akita11/PT2/FW/LED_definition.md

# LEDの挙動

LEDの挙動は以下の通りとします。

## 起動時

50msごとにで全LEDを順に1個ずつのみ点灯（他は消灯）、ランダムな色で点灯させ、最後に全消灯。

## プログラム実行中

- 実行中のブロックを赤で点滅。
- loopブロックのLEDは、loopを実行中は緑色で点灯。loop実行が終わったら、そのブロックは消灯。

## プログラム終了後

200ms周期で3回、全LEDを青点滅
