akita11/PT2/PCB/PT2one.kicad_pcb

## KiCad design PCB/PT2one.kicad_pcb (2026-10-09)

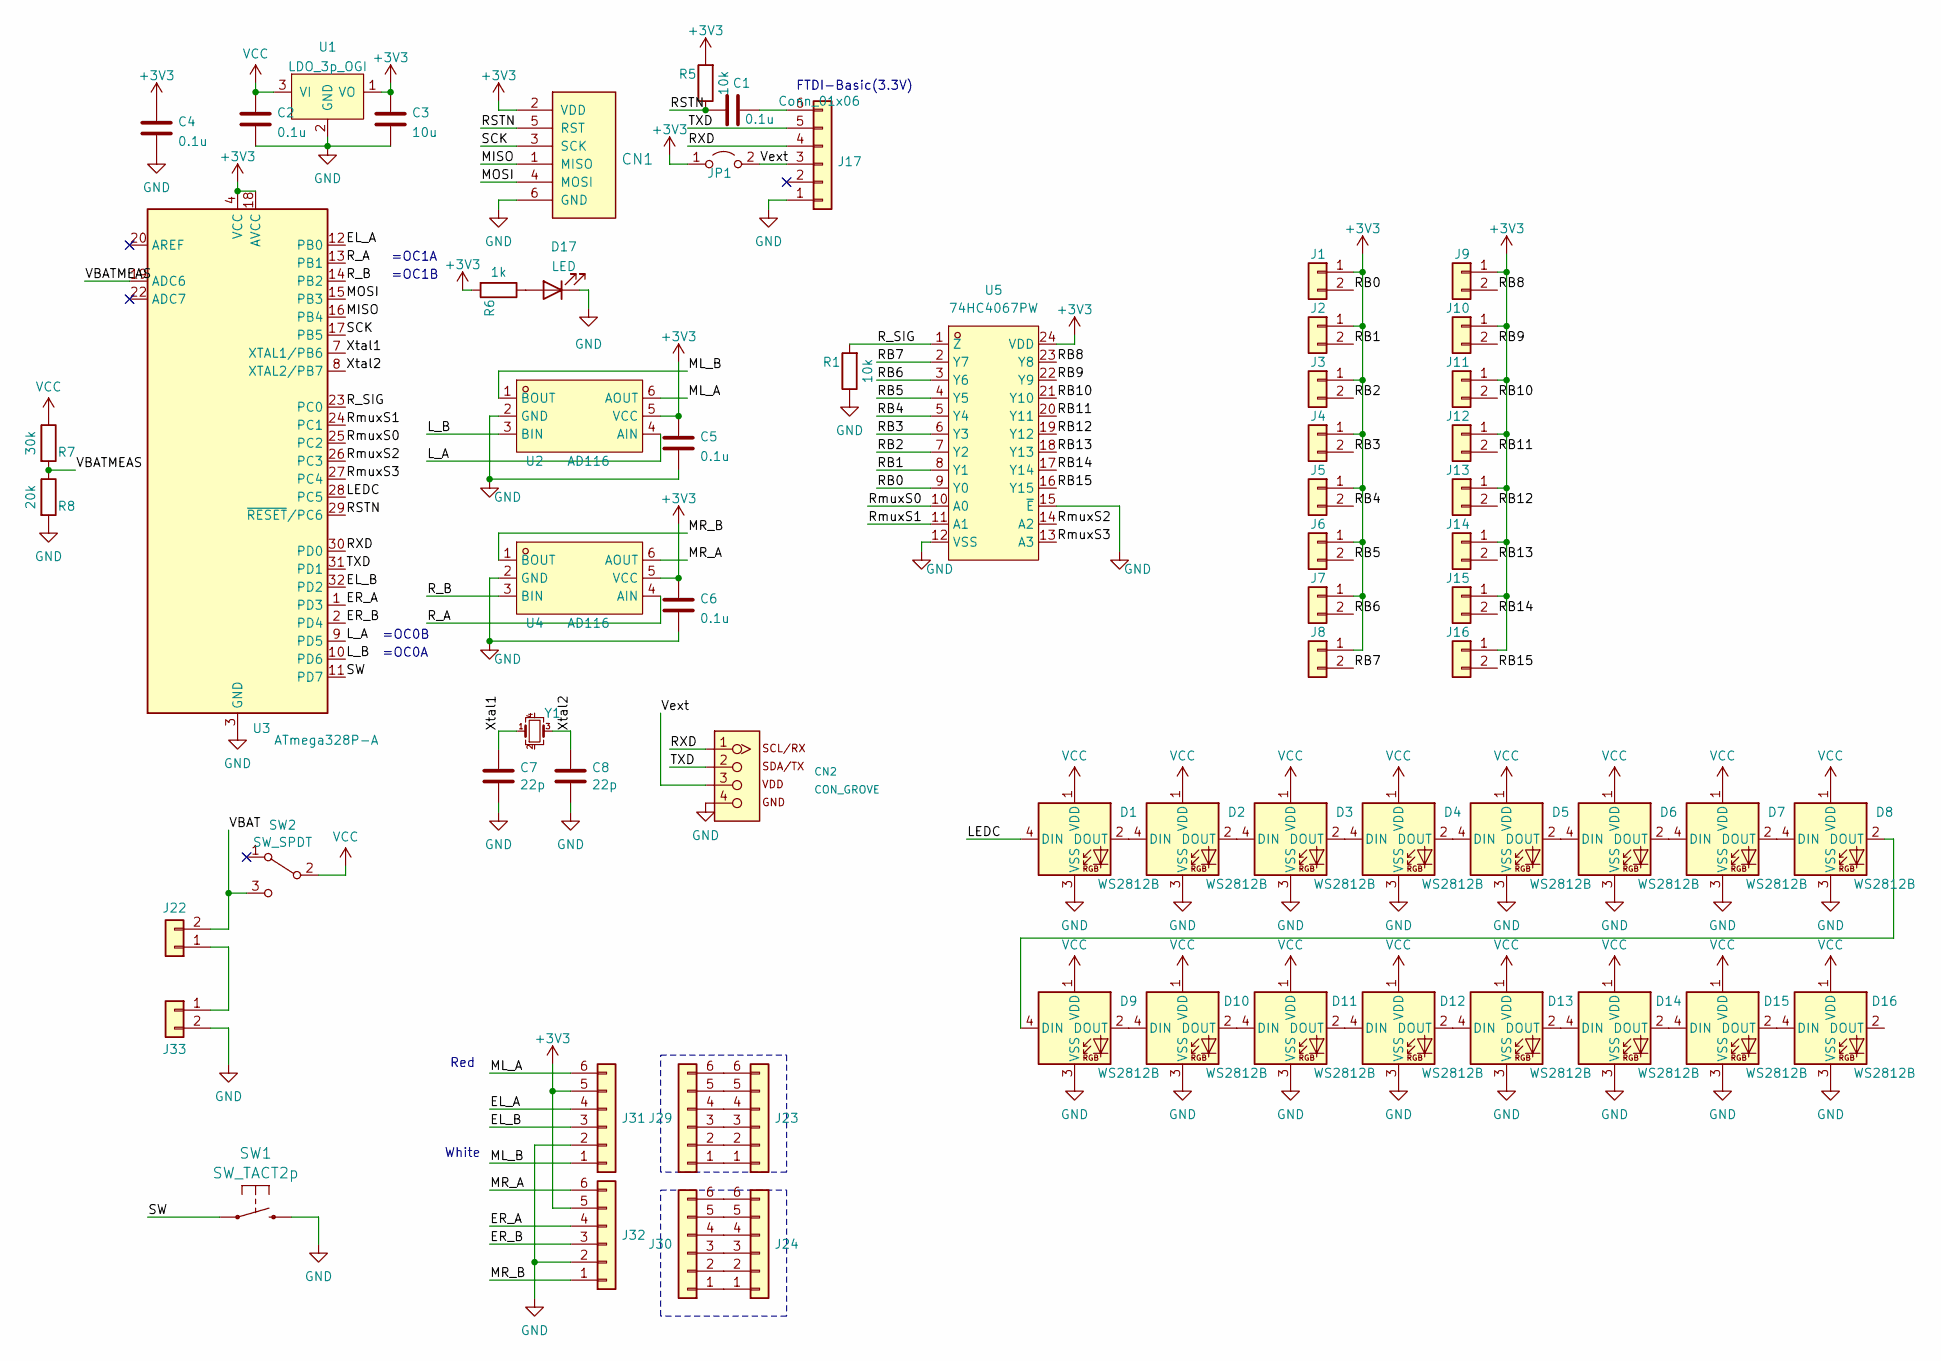
[picture p1: schematic PT2one.kicad_sch]

Parts:
C1, C2, C4, C5, C6: 0.1u; C_0603_1608Metric
C3: 10u; C_0603_1608Metric
C7, C8: 22p; C_0603_1608Metric
CN1: CON_AVRISP; PinHeader_2x03_P2.54mm_Vertical
CN2: CON_GROVE; CON_GROVE_H_roundPad
D1, D2, D3, D4, D5, D6, D7, D8, D9, D10, D11, D12, D13, D14, D15, D16: WS2812B; LED_WS2812B_PLCC4_5.0x5.0mm_P3.2mm
D17: LED; LED_0603_1608Metric
J1, J2, J3, J4, J5, J6, J7, J8, J9, J10, J11, J12, J13, J14, J15, J16: Conn_01x02; CON_MagConn2_NoTab
J17: Conn_01x06; PinSocket_1x06_P2.54mm_Horizontal
J22: Conn_01x02; BAT_UM3x1
J23, J24: Conn_01x06; CON_PinSocket_1.5mmx6V
J29, J30: Conn_01x06; PinHeader_2x03_P2.54mm_Vertical
J31, J32: Conn_01x06; PinHeader_2x03_P2.54mm_Horizontal
J33: Conn_01x02; BAT_UM3x2
JP1: Jumper_2_Open; SolderJumper-2_P1.3mm_Open_Pad1.0x1.5mm
R1, R5: 10k; R_0603_1608Metric
R6: 1k; R_0603_1608Metric
R7: 30k; R_0603_1608Metric
R8: 20k; R_0603_1608Metric
SW1: SW_TACT2p; SW_PUSH-12mm
SW2: SW_SPDT; SW_SK-12D11VG3
U1: LDO_3p_OGI; SOT-89-3; LCSC C920514
U2, U4: AD116; SOT-23-6_L2.9-W1.6-P0.95-LS2.8-BL; LCSC Part C7463412
U3: ATmega328P-A; TQFP-32_7x7mm_P0.8mm; LCSC C14877
U5: 74HC4067PW; TSSOP-24_L7.8-W4.4-P0.65-LS6.4-BL; MPN 74HC4067PW(LX); LCSC Part C22390251
Y1: Crystal_GND24_Small; Crystal_SMD_2520-4Pin_2.5x2.0mm

Connections:
+3V3: C3.1, C4.1, C5.1, C6.1, CN1.2 (VDD), J1.1, J2.1, J3.1, J4.1, J5.1, J6.1, J7.1, J8.1, J9.1, J10.1, J11.1, J12.1, J13.1, J14.1, J15.1, J16.1, J31.5, J32.5, JP1.1 (A), R5.2, R6.2, U1.1 (VO), U2.5 (VCC), U3.4 (VCC), U3.6 (VCC), U3.18 (AVCC), U4.5 (VCC), U5.24 (VDD)
/EL_A: J31.4, U3.12 (PB0)
/EL_B: J31.3, U3.32 (PD2)
/ER_A: J32.4, U3.1 (PD3)
/ER_B: J32.3, U3.2 (PD4)
/LEDC: D1.4 (DIN), U3.28 (PC5)
/L_A: U2.4 (AIN), U3.9 (PD5)
/L_B: U2.3 (BIN), U3.10 (PD6)
/MISO: CN1.1 (MISO), U3.16 (PB4)
/ML_A: J31.6, U2.6 (AOUT)
/ML_B: J31.1, U2.1 (BOUT)
/MOSI: CN1.4 (MOSI), U3.15 (PB3)
/MR_A: J32.6, U4.6 (AOUT)
/MR_B: J32.1, U4.1 (BOUT)
/RB0: J1.2, U5.9 (Y0)
/RB1: J2.2, U5.8 (Y1)
/RB2: J3.2, U5.7 (Y2)
/RB3: J4.2, U5.6 (Y3)
/RB4: J5.2, U5.5 (Y4)
/RB5: J6.2, U5.4 (Y5)
/RB6: J7.2, U5.3 (Y6)
/RB7: J8.2, U5.2 (Y7)
/RB8: J9.2, U5.23 (Y8)
/RB9: J10.2, U5.22 (Y9)
/RB10: J11.2, U5.21 (Y10)
/RB11: J12.2, U5.20 (Y11)
/RB12: J13.2, U5.19 (Y12)
/RB13: J14.2, U5.18 (Y13)
/RB14: J15.2, U5.17 (Y14)
/RB15: J16.2, U5.16 (Y15)
/RSTN: C1.1, CN1.5 (RST), R5.1, U3.29 (~RESET/PC6)
/RXD: CN2.1, J17.4, U3.30 (PD0)
/R_A: U3.13 (PB1), U4.4 (AIN)
/R_B: U3.14 (PB2), U4.3 (BIN)
/R_SIG: R1.2, U3.23 (PC0), U5.1 (Z)
/RmuxS0: U3.25 (PC2), U5.10 (A0)
/RmuxS1: U3.24 (PC1), U5.11 (A1)
/RmuxS2: U3.26 (PC3), U5.14 (A2)
/RmuxS3: U3.27 (PC4), U5.13 (A3)
/SCK: CN1.3 (SCK), U3.17 (PB5)
/SW: SW1.1, U3.11 (PD7)
/TXD: CN2.2, J17.5, U3.31 (PD1)
/VBAT: J22.2, SW2.3 (C)
/VBATMEAS: R7.2, R8.1, U3.19 (ADC6)
/Vext: CN2.3, J17.3, JP1.2 (B)
/Xtal1: C7.1, U3.7 (XTAL1/PB6), Y1.1
/Xtal2: C8.1, U3.8 (XTAL2/PB7), Y1.3
GND: C2.2, C3.2, C4.2, C5.2, C6.2, C7.2, C8.2, CN1.6 (GND), CN2.4, D1.3 (VSS), D2.3 (VSS), D3.3 (VSS), D4.3 (VSS), D5.3 (VSS), D6.3 (VSS), D7.3 (VSS), D8.3 (VSS), D9.3 (VSS), D10.3 (VSS), D11.3 (VSS), D12.3 (VSS), D13.3 (VSS), D14.3 (VSS), D15.3 (VSS), D16.3 (VSS), D17.1 (K), J17.1, J31.2, J32.2, J33.2, R1.1, R8.2, SW1.2, U1.2 (GND), U2.2 (GND), U3.3 (GND), U3.5 (GND), U3.21 (GND), U4.2 (GND), U5.12 (VSS), U5.15 (~E)
unnamed: D1.2 (DOUT), D2.4 (DIN)
unnamed: D2.2 (DOUT), D3.4 (DIN)
unnamed: D3.2 (DOUT), D4.4 (DIN)
unnamed: D4.2 (DOUT), D5.4 (DIN)
unnamed: D5.2 (DOUT), D6.4 (DIN)
unnamed: D6.2 (DOUT), D7.4 (DIN)
unnamed: D7.2 (DOUT), D8.4 (DIN)
unnamed: D8.2 (DOUT), D9.4 (DIN)
unnamed: D9.2 (DOUT), D10.4 (DIN)
unnamed: D10.2 (DOUT), D11.4 (DIN)
unnamed: D11.2 (DOUT), D12.4 (DIN)
unnamed: D12.2 (DOUT), D13.4 (DIN)
unnamed: D13.2 (DOUT), D14.4 (DIN)
unnamed: D14.2 (DOUT), D15.4 (DIN)
unnamed: D15.2 (DOUT), D16.4 (DIN)
unnamed: D17.2 (A), R6.1
unnamed: C1.2, J17.6
unnamed: J22.1, J33.1
unnamed: J23.1, J29.1
unnamed: J23.2, J29.2
unnamed: J23.3, J29.3
unnamed: J23.4, J29.4
unnamed: J23.5, J29.5
unnamed: J23.6, J29.6
unnamed: J24.1, J30.1
unnamed: J24.2, J30.2
unnamed: J24.3, J30.3
unnamed: J24.4, J30.4
unnamed: J24.5, J30.5
unnamed: J24.6, J30.6
VCC: C2.1, D1.1 (VDD), D2.1 (VDD), D3.1 (VDD), D4.1 (VDD), D5.1 (VDD), D6.1 (VDD), D7.1 (VDD), D8.1 (VDD), D9.1 (VDD), D10.1 (VDD), D11.1 (VDD), D12.1 (VDD), D13.1 (VDD), D14.1 (VDD), D15.1 (VDD), D16.1 (VDD), R7.1, SW2.2 (B), U1.3 (VI)

Notes on the sheet:
Red
FTDI-Basic(3.3V)
=OC1A
White
=OC1B
=OC0B
=OC0A

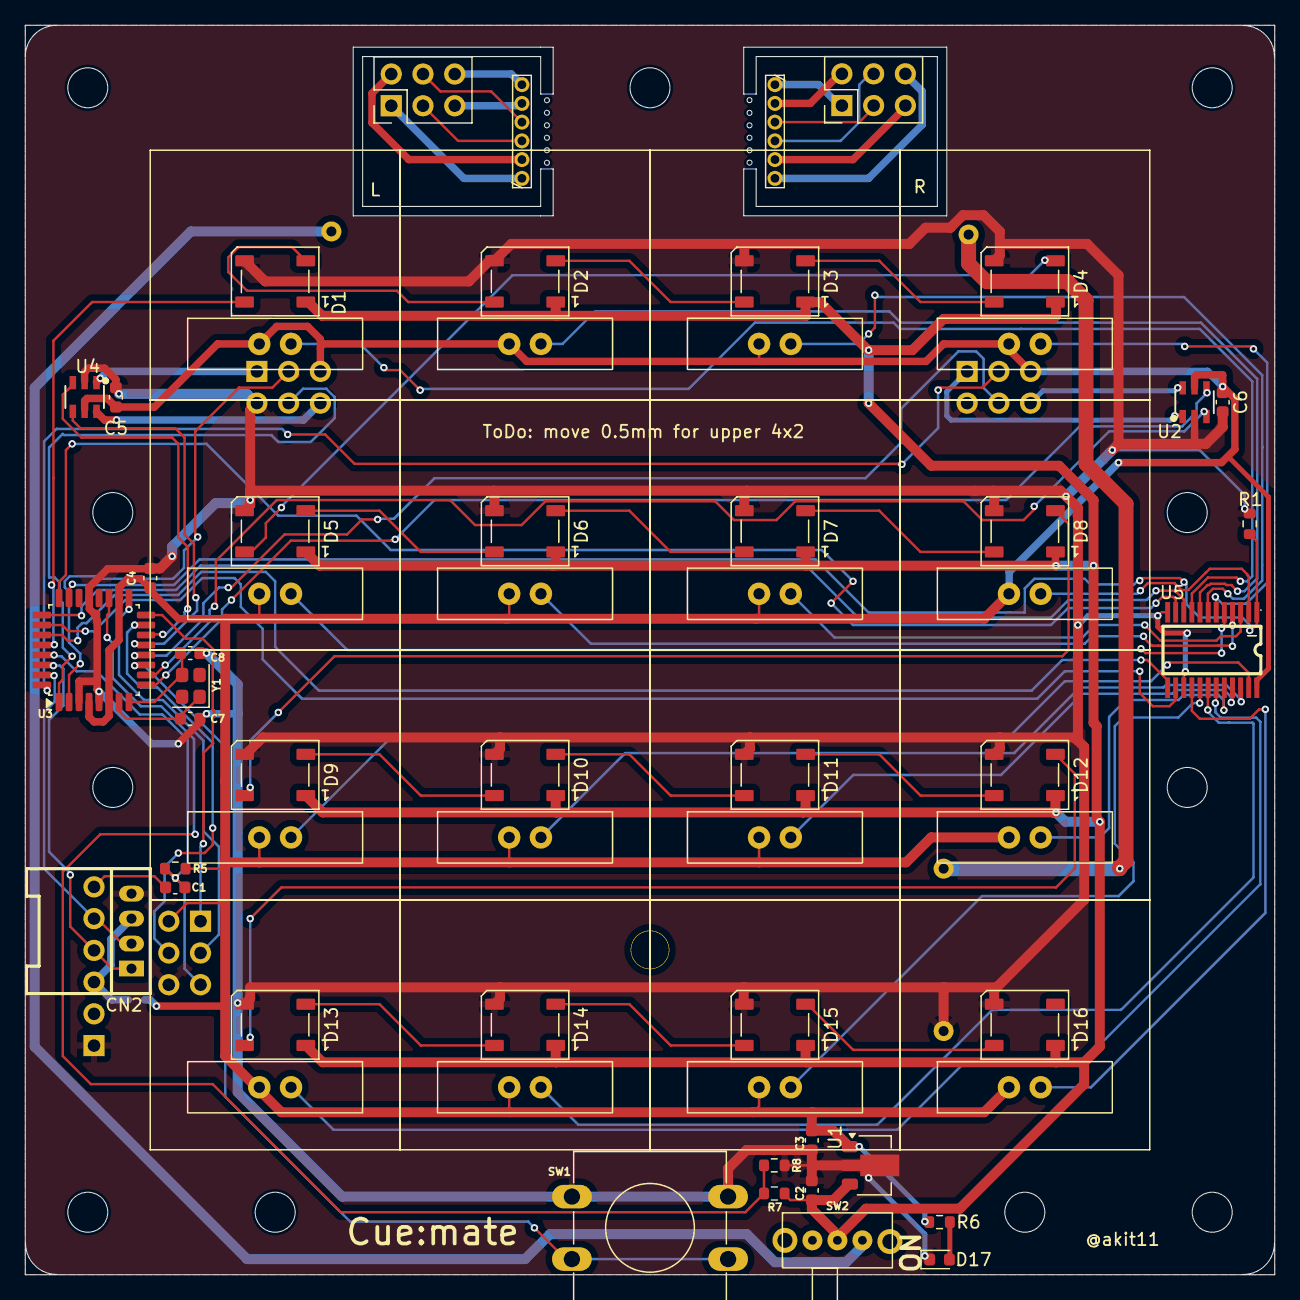
[picture p2: board PT2one.kicad_pcb from above]

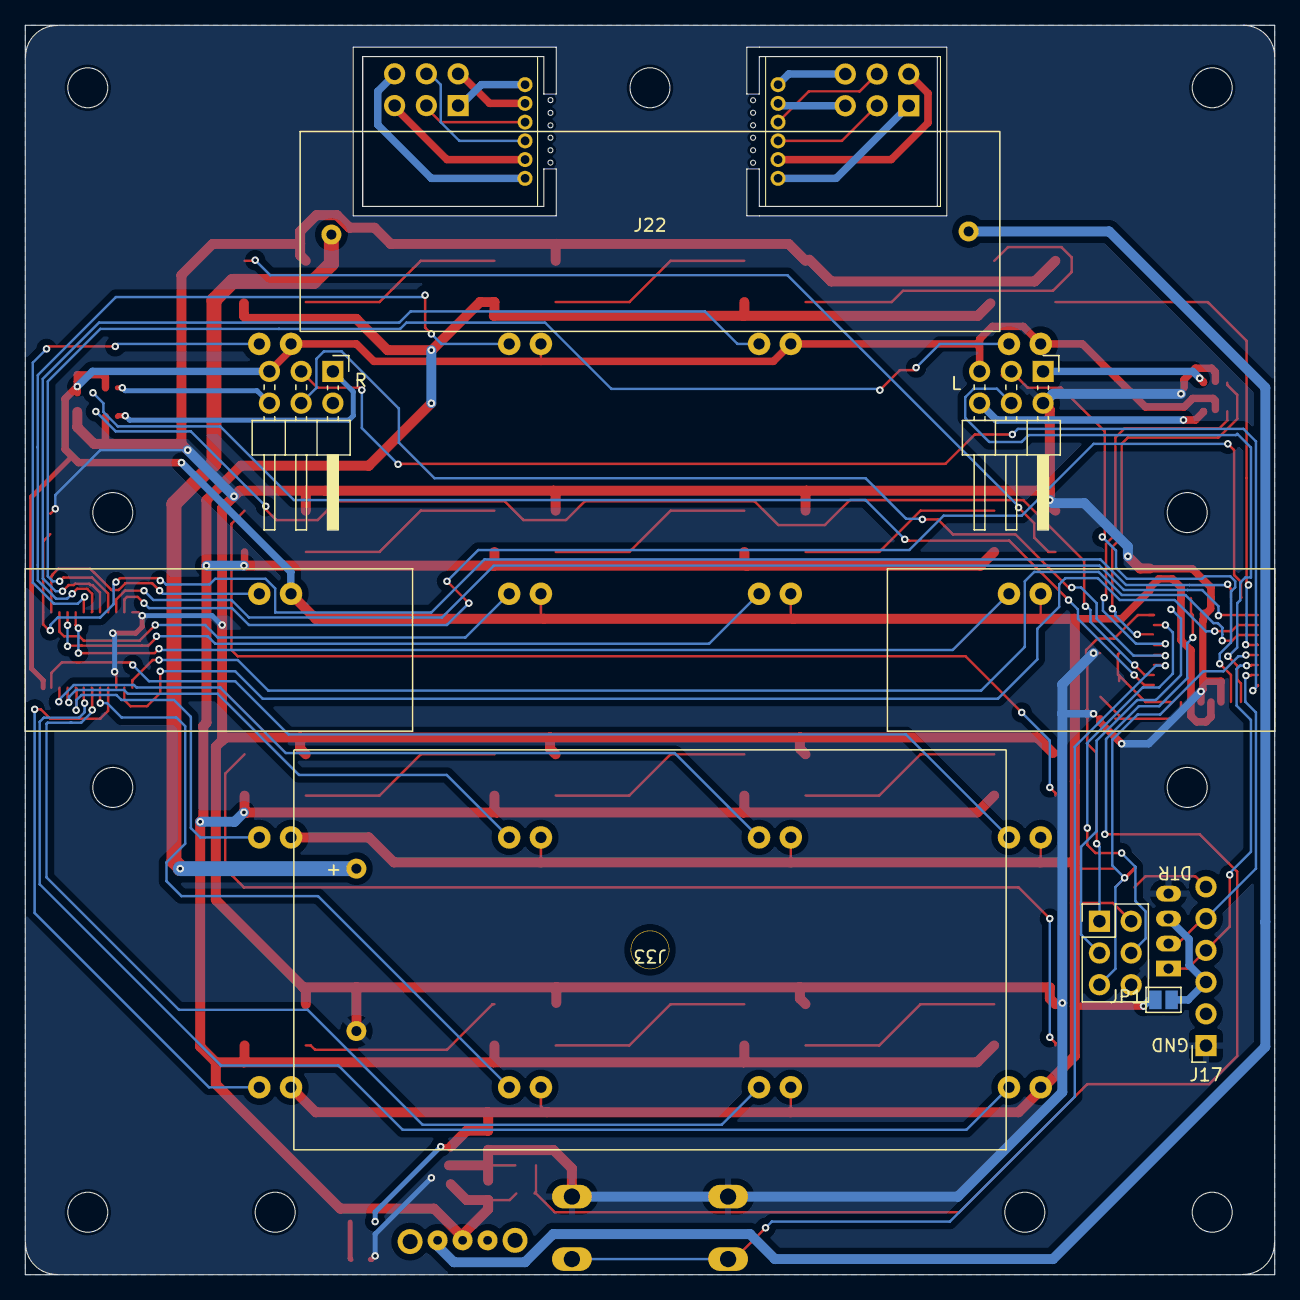
[picture p3: board PT2one.kicad_pcb from below]

Board: 2 copper layers, 100.0 x 100.0 mm, 66 parts (7 on the bottom side), 79 nets.
