akita11/PT2/(commit log)

2026-08-23 motor&enc test
2026-10-09 add PCB, working FW
